MirMaiti/RainRainGoAway_2025/README.md

# RainRainGoAway_2025
I have implemented an automated rain-detection and wiper control mechanism that: 

• Rotates the wiper upon rain detection 

• Displays the speed level of the wiper based on the amount of rain falling
