MirMaiti/RainRainGoAway_2025/76_rain_rain_go_away_ckt_ltspice.asc

A1: or; Vhigh=5 Vlow=0 Ref=2.5 td=10n trise=5n
A2: and; Vhigh=5 Vlow=0 Ref=2.5 td=10n trise=5n
A3: inv; Vhigh=5 Vlow=0 Ref=2.5 td=10n trise=5n
A4: buf1; Vhigh=5 Vlow=0 Ref=2.5 td=10n trise=5n
A5: and; Vhigh=5 Vlow=0 Ref=2.5 td=10n trise=5n
A6: and; Vhigh=5 Vlow=0 Ref=2.5 td=10n trise=5n
A7: and; Vhigh=5 Vlow=0 Ref=2.5 td=10n trise=5n
A8: and; Vhigh=5 Vlow=0 Ref=2.5 td=10n trise=5n
B1: or; Vhigh=5 Vlow=0 Ref=2.5 td=10n trise=5n
C1: cap; 0.005µF; V=4 Irms=0 Rser=0 Lser=0
D2: diode; 1N4007
L2: ind; 0.26mH
M2: pmos; irf9540npbf
R1: res; 10k
R2: res; 1k
R3: res; 220
R5: res; 330k
R6: res; 110k
R7: res; 868
R8: res; 910
R9: res; 1k
R10: res; 2.2k
R11: res; 1k
R12: res; 10k
R13: res; 10k
R15: res; 13
U1: LM741
U2: LM339; LM324
U3: LM741
U4: LM741
U5: LM741
U6: LM741
U7: LM339; LM324
U8: LM339; LM324
U9: LM339; LM324
U10: LM339; LM324
V1: voltage; 12
V2: voltage; 12
V3: voltage; 2
V4: voltage; 12
V5: voltage; 12
V6: voltage; 12
V7: voltage; 1
V8: voltage; 12
V9: voltage; 0
V10: voltage; 12
V11: voltage; 12
V12: voltage; 12
V13: voltage; 12
V18: voltage; 12
V19: voltage; 12
V20: voltage; 12
V21: voltage; 2
V22: voltage; 3
V23: voltage; 9
V24: voltage; 9
Named nets: 0
.tran 5ms
.model D3VZener D(Is=1e-9 Rs=0.1 N=1.2 Ikf=0.1 Xti=3 Eg=1.11 Cjo=2e-12 Vj=0.75 M=0.33 Fc=0.5 Bv=3.0 Ibv=0.005 Isr=1e-7 Nr=2 Tt=0)
* LM339 VOLTAGE COMPARATOR "MACROMODEL" SUBCIRCUIT
* CREATED USING PARTS VERSION 4.03 ON 03/07/90 AT 14:17
* REV (N/A)
* CONNECTIONS:   NON-INVERTING INPUT
*                | INVERTING INPUT
*                | | POSITIVE POWER SUPPLY
*                | | | NEGATIVE POWER SUPPLY
*                | | | | OPEN COLLECTOR OUTPUT
*                | | | | |
.SUBCKT LM339    1 2 3 4 5
*
  F1    9  3 V1 1
  IEE   3  7 DC 100.0E-6
  VI1  21  1 DC .75
  VI2  22  2 DC .75
  Q1    9 21  7 QIN
  Q2    8 22  7 QIN
  Q3    9  8  4 QMO
  Q4    8  8  4 QMI
.MODEL QIN PNP(IS=800.0E-18 BF=2.000E3)
.MODEL QMI NPN(IS=800.0E-18 BF=1002)
.MODEL QMO NPN(IS=800.0E-18 BF=1000 CJC=1E-15 TR=807.4E-9)
  E1   10  4  9  4  1
  V1   10 11 DC 0
  Q5    5 11  4 QOC
.MODEL QOC NPN(IS=800.0E-18 BF=20.29E3 CJC=1E-15 TF=942.6E-12 TR=543.8E-9)
  DP    4  3 DX
  RP 3  4 46.3E3
.MODEL DX  D(IS=800.0E-18)
*
.ENDS
2
3
4
6
7
* LM324 OPERATIONAL AMPLIFIER "MACROMODEL" SUBCIRCUIT
* CREATED USING PARTS RELEASE 4.01 ON 09/08/89 AT 10:54
* (REV N/A)      SUPPLY VOLTAGE: 5V
* CONNECTIONS:   NON-INVERTING INPUT
*                | INVERTING INPUT
*                | | POSITIVE POWER SUPPLY
*                | | | NEGATIVE POWER SUPPLY
*                | | | | OUTPUT
*                | | | | |
.SUBCKT LM324    1 2 3 4 5
*
  C1   11 12 5.544E-12
  C2    6  7 20.00E-12
  DC    5 53 DX
  DE   54  5 DX
  DLP  90 91 DX
  DLN  92 90 DX
  DP    4  3 DX
  EGND 99  0 POLY(2) (3,0) (4,0) 0 .5 .5
  FB    7 99 POLY(5) VB VC VE VLP VLN 0 15.91E6 -20E6 20E6 20E6 -20E6
  GA    6  0 11 12 125.7E-6
  GCM   0  6 10 99 7.067E-9
  IEE   3 10 DC 10.04E-6
  HLIM 90  0 VLIM 1K
  Q1   11  2 13 QX
  Q2   12  1 14 QX
  R2    6  9 100.0E3
  RC1   4 11 7.957E3
  RC2   4 12 7.957E3
  RE1  13 10 2.773E3
  RE2  14 10 2.773E3
  REE  10 99 19.92E6
  RO1   8  5 50
  RO2   7 99 50
  RP    3  4 30.31E3
  VB    9  0 DC 0
  VC 3 53 DC 2.100
  VE   54  4 DC .6
  VLIM  7  8 DC 0
  VLP  91  0 DC 40
  VLN   0 92 DC 40
.MODEL DX D(IS=800.0E-18)
.MODEL QX PNP(IS=800.0E-18 BF=250)
.ENDS
.tran 100ms
7
4
4
7
2
2
3
3
6
6
V7 to PWM
.SUBCKT irf9540npbf 1 2 3
**************************************
*      Model Generated by MODPEX     *
*Copyright(c) Symmetry Design Systems*
*         All Rights Reserved        *
*    UNPUBLISHED LICENSED SOFTWARE   *
*   Contains Proprietary Information *
*      Which is The Property of      *
*     SYMMETRY OR ITS LICENSORS      *
*Commercial Use or Resale Restricted *
*   by Symmetry License Agreement    *
**************************************
* Model generated on Aug 15, 17
* MODEL FORMAT: SPICE3
* Symmetry POWER MOS Model (Version 1.0)
* External Node Designations
* Node 1 -> Drain
* Node 2 -> Gate
* Node 3 -> Source
M1 9 7 8 8 MM L=100u W=100u
.MODEL MM PMOS LEVEL=1 IS=1e-32
+VTO=-3.74034 LAMBDA=0.00254531 KP=6.90462
+CGSO=1.15995e-05 CGDO=1e-11
RS 8 3 0.0448511
D1 1 3 MD
.MODEL MD D IS=4.56468e-09 RS=0.00874877 N=1.45317 BV=100
+IBV=0.00025 EG=1.15553 XTI=3.00117 TT=1e-07
+CJO=9.64423e-10 VJ=0.500897 M=0.387171 FC=0.5
RDS 3 1 2e+07
RD 9 1 0.0421247
RG 2 7 6.66725
D2 5 4 MD1
* Default values used in MD1:
*   RS=0 EG=1.11 XTI=3.0 TT=0
*   BV=infinite IBV=1mA
.MODEL MD1 D IS=1e-32 N=50
+CJO=3.36744e-09 VJ=0.5 M=0.683702 FC=1e-08
D3 5 0 MD2
* Default values used in MD2:
*   EG=1.11 XTI=3.0 TT=0 CJO=0
*   BV=infinite IBV=1mA
.MODEL MD2 D IS=1e-10 N=0.4 RS=2.99982e-06
RL 5 10 1
FI2 7 9 VFI2 -1
VFI2 4 0 0
EV16 10 0 9 7 1
CAP 11 10 3.66446e-09
FI1 7 9 VFI1 -1
VFI1 11 6 0
RCAP 6 10 1
D4 6 0 MD3
* Default values used in MD3:
*   EG=1.11 XTI=3.0 TT=0 CJO=0
*   RS=0 BV=infinite IBV=1mA
.MODEL MD3 D IS=1e-10 N=0.4
.ENDS irf9540npbf
2
3
11
4
1
The R-L values are representative and can be adjusted based on actual motor specifications
Component Subcircuit specifications
Output of the digital logic circuit
(It is one hot encoded)
Digital to Analog Converter
Triangular waveform generator
High
Medium-High
Medium-Low
Low
